schto173/FormulaLAM/Electrical/ESC-BLDC-FORMULA1-V2_0/bldc-75v.kicad_pcb

## KiCad design Electrical/ESC-BLDC-FORMULA1-V2_0/bldc-75v.kicad_pcb (2026-10-26)

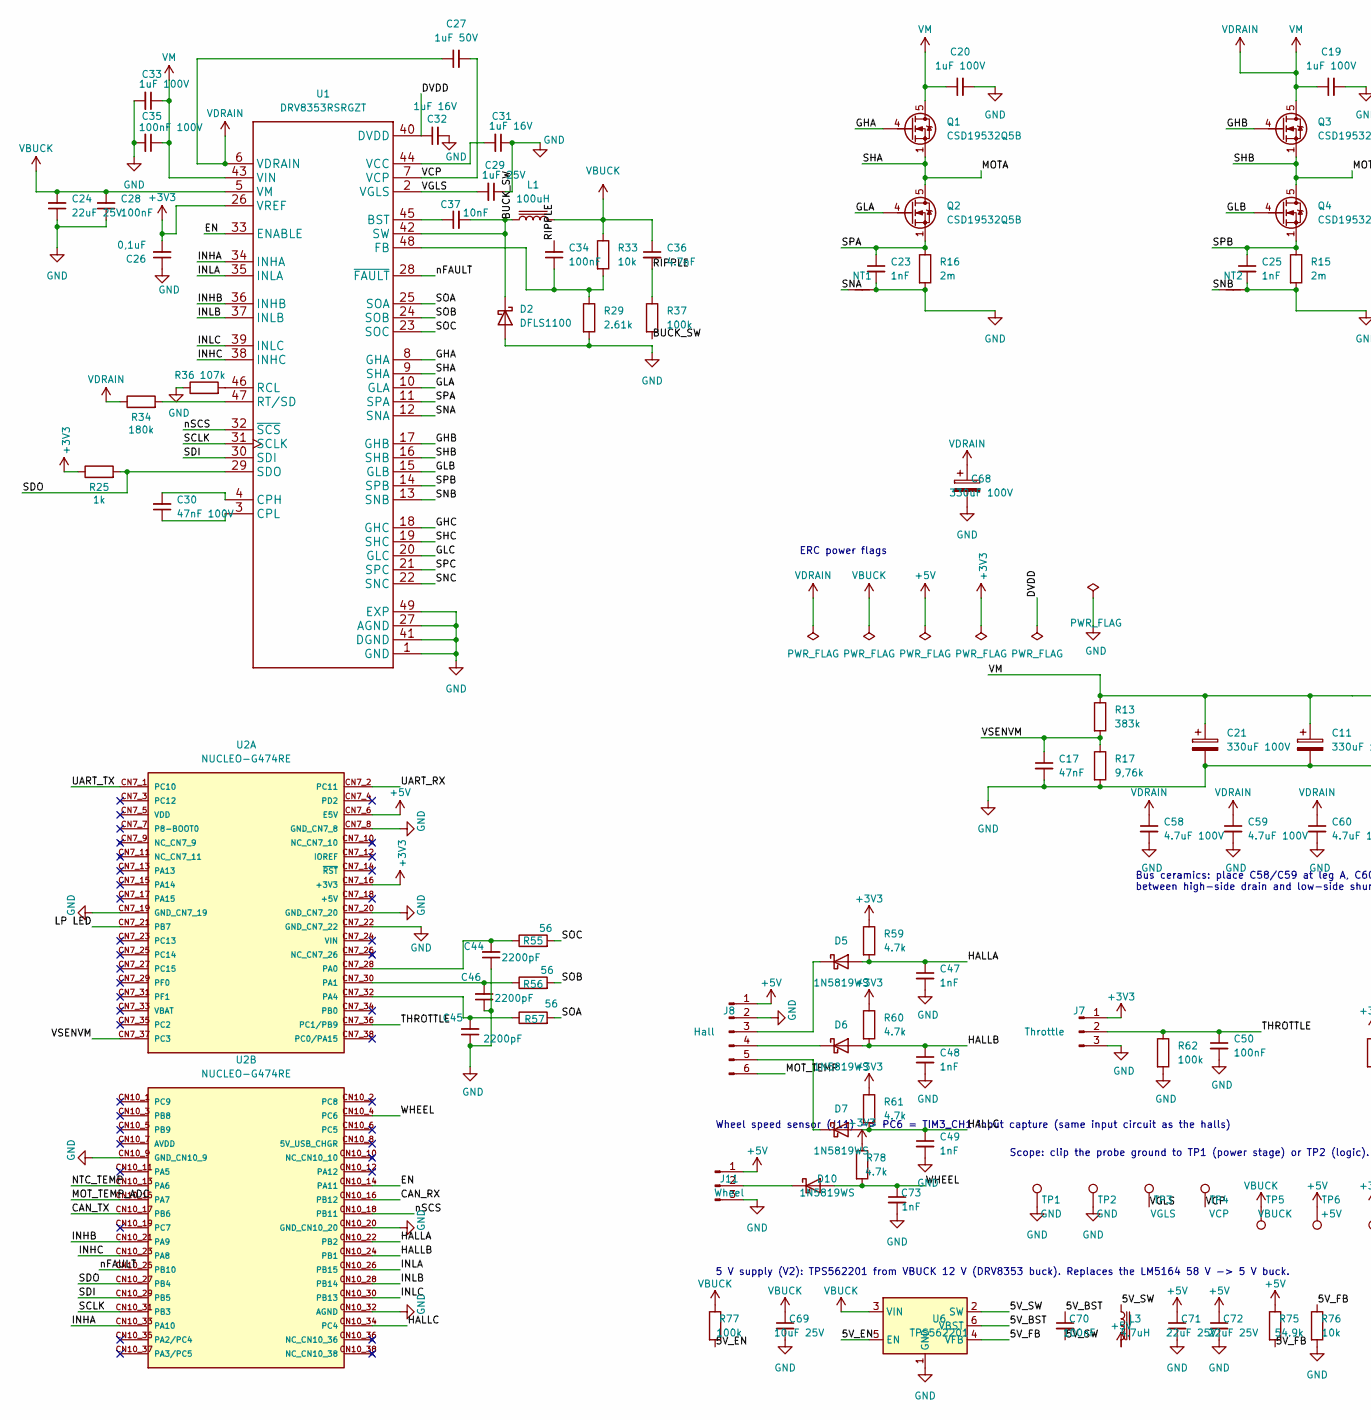
[picture p1: schematic bldc-75v.kicad_sch, part in row 1, column 1]

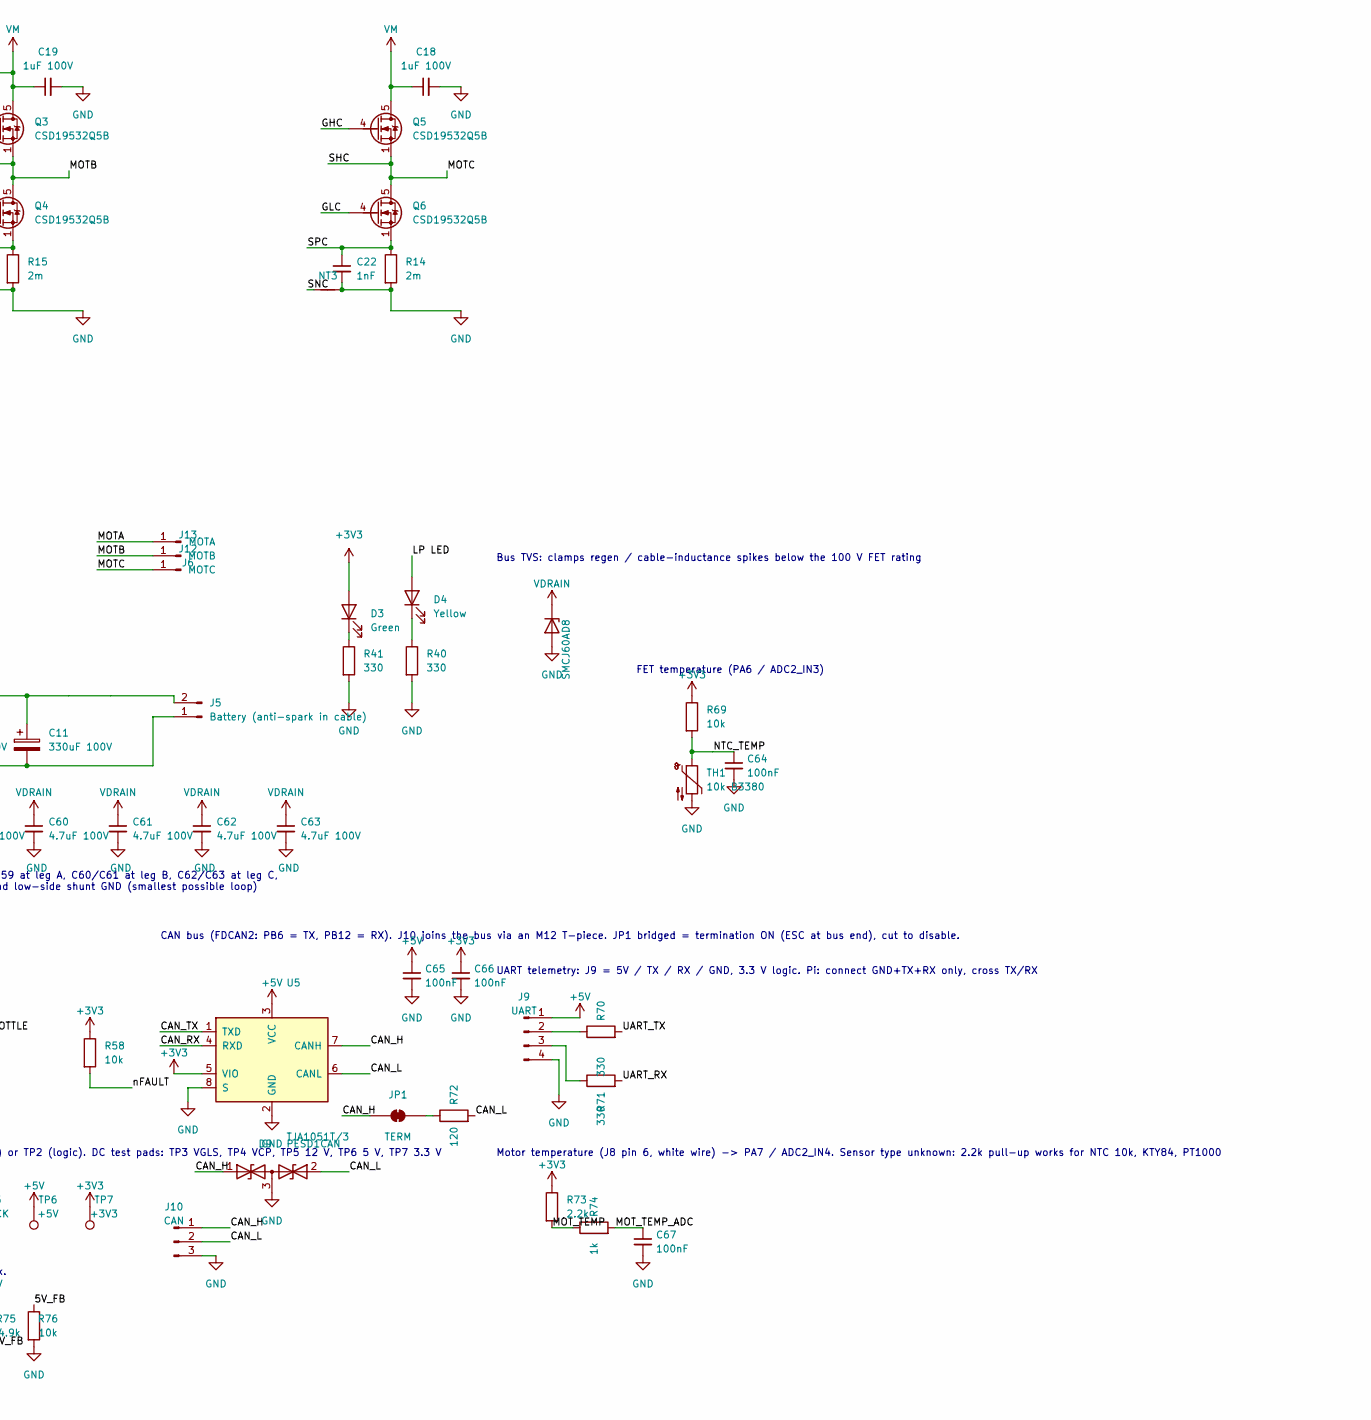
[picture p2: schematic bldc-75v.kicad_sch, part in row 1, column 2]

Parts:
C11, C21, C68: 330uF 100V; CP_Radial_D16.0mm_P7.50mm; LCSC C346987
C17: 47nF; C_0603_1608Metric; LCSC C1622
C18, C19, C20, C33: 1uF 100V; C_1206_3216Metric; LCSC C13832
C22, C23, C25, C47, C48, C49, C73: 1nF; C_0603_1608Metric; LCSC C1588
C24: 22uF 25V; C_0805_2012Metric; LCSC C45783
C26: 0,1uF; C_0603_1608Metric; LCSC C14663
C27: 1uF 50V; C_0603_1608Metric; LCSC C15849
C28, C34, C50, C64, C65, C66, C67, C70: 100nF; C_0603_1608Metric; LCSC C14663
C29: 1uF 25V; C_0603_1608Metric; LCSC C15849
C30: 47nF 100V; C_0603_1608Metric; LCSC C576852
C31, C32: 1uF 16V; C_0603_1608Metric; LCSC C15849
C35: 100nF 100V; C_0805_2012Metric; LCSC C28233
C36: 4.7nF; C_0603_1608Metric; LCSC C53987
C37: 10nF; C_0603_1608Metric; LCSC C57112
C44, C45, C46: 2200pF; C_0603_1608Metric; LCSC C1604
C58, C59, C60, C61, C62, C63: 4.7uF 100V; C_1210_3225Metric; LCSC C385986
C69: 10uF 25V; C_0805_2012Metric; LCSC C15850
C71, C72: 22uF 25V; C_1206_3216Metric; LCSC C12891
D2: DFLS1100; D_PowerDI-123; LCSC C107674
D3: Green; LED_0603_1608Metric; LCSC C12624
D4: Yellow; LED_0603_1608Metric; LCSC C2287
D5, D6, D7, D10: 1N5819WS; D_SOD-323; LCSC C191023
D8: SMCJ60A; D_SMC; LCSC C224057
D9: PESD1CAN; SOT-23; LCSC C15771
J5: Battery (anti-spark in cable); SolderWire-2.5sqmm_1x02_P8.8mm_D2.4mm_OD4.4mm
J6: MOTC; SolderWire-2.5sqmm_1x01_D2.4mm_OD4.4mm
J7: Throttle; JST_XH_B3B-XH-A_1x03_P2.50mm_Vertical; LCSC C144394
J8: Hall; JST_XH_B6B-XH-A_1x06_P2.50mm_Vertical; LCSC C144397
J9: UART; JST_XH_B4B-XH-A_1x04_P2.50mm_Vertical; LCSC C144395
J10: CAN; JST_XH_B3B-XH-A_1x03_P2.50mm_Vertical; LCSC C144394
J11: Wheel; JST_XH_B3B-XH-A_1x03_P2.50mm_Vertical; LCSC C144394
J12: MOTB; SolderWire-2.5sqmm_1x01_D2.4mm_OD4.4mm
J13: MOTA; SolderWire-2.5sqmm_1x01_D2.4mm_OD4.4mm
JP1: TERM; SolderJumper-2_P1.3mm_Bridged_RoundedPad1.0x1.5mm
L1: 100uH; L_Sunlord_SWPA6045S; LCSC C60633
L3: 4.7uH; L_Sunlord_SWPA4030S; LCSC C57269
NT1, NT2, NT3: NetTie_2; NetTie-2_SMD_Pad0.5mm
Q1, Q2, Q3, Q4, Q5, Q6: CSD19532Q5B; TDSON-8-1; LCSC C473333
R13: 383k; R_1206_3216Metric; LCSC C247277
R14, R15, R16: 2m; R_2512_6332Metric; LCSC C154685
R17: 9,76k; R_0603_1608Metric; LCSC C23128
R25, R74: 1k; R_0603_1608Metric; LCSC C21190
R29: 2.61k; R_0603_1608Metric; LCSC C22942
R33, R58, R69, R76: 10k; R_0603_1608Metric; LCSC C25804
R34: 180k; R_1206_3216Metric; LCSC C17923
R36: 107k; R_0603_1608Metric; LCSC C14889
R37: 100k; R_1206_3216Metric; LCSC C17900
R40, R41, R70, R71: 330; R_0603_1608Metric; LCSC C23138
R55, R56, R57: 56; R_0603_1608Metric; LCSC C25196
R59, R60, R61, R78: 4.7k; R_0603_1608Metric; LCSC C23162
R62, R77: 100k; R_0603_1608Metric; LCSC C25803
R72: 120; R_0603_1608Metric; LCSC C22787
R73: 2.2k; R_0603_1608Metric; LCSC C4190
R75: 54.9k; R_0603_1608Metric; LCSC C23077
TH1: 10k B3380; R_0402_1005Metric; LCSC C77131
TP1, TP2: GND; TestPoint_Keystone_5000-5004_Miniature; LCSC C238122
TP3: VGLS; TestPoint_Pad_D1.5mm
TP4: VCP; TestPoint_Pad_D1.5mm
TP5: VBUCK; TestPoint_Pad_D1.5mm
TP6: +5V; TestPoint_Pad_D1.5mm
TP7: +3V3; TestPoint_Pad_D1.5mm
U1: DRV8353RSRGZT; QFN50P700X700X100-49N; PARTREV A; LCSC C506246
U2: NUCLEO-G474RE; Nucleo64_Morpho_HAT; PARTREV 17
U5: TJA1051T/3; SOIC-8_3.9x4.9mm_P1.27mm; LCSC C38695
U6: TPS562201; TSOT-23-6; LCSC C90061

Connections:
+3V3: C26.2, C66.1, D3.2 (A), J7.1, R25.1, R58.1, R59.1, R60.1, R61.1, R69.1, R73.1, R78.1, TP7.1, U1.26 (VREF), U2.CN7_16 (+3V3), U5.5 (VIO)
+5V: C65.1, C71.1, C72.1, J8.1, J9.1, J11.1, L3.2, R75.1, TP6.1, U2.CN7_6 (E5V), U5.3 (VCC)
/5V_BST: C70.1, U6.6 (VBST)
/5V_EN: R77.2, U6.5 (EN)
/5V_FB: R75.2, R76.1, U6.4 (VFB)
/5V_SW: C70.2, L3.1, U6.2 (SW)
/BUCK_SW: C37.2, D2.1 (K), L1.1, R37.2, U1.42 (SW)
/CAN_H: D9.1 (A1), J10.1, JP1.1 (A), U5.7 (CANH)
/CAN_L: D9.2 (A2), J10.2, R72.2, U5.6 (CANL)
/CAN_RX: U2.CN10_16 (PB12), U5.4 (RXD)
/CAN_TX: U2.CN10_17 (PB6), U5.1 (TXD)
/DVDD: C32.1, U1.40 (DVDD)
/EN: U1.33 (ENABLE), U2.CN10_14 (PA11)
/GHA: Q1.4 (G), U1.8 (GHA)
/GHB: Q3.4 (G), U1.17 (GHB)
/GHC: Q5.4 (G), U1.18 (GHC)
/GLA: Q2.4 (G), U1.10 (GLA)
/GLB: Q4.4 (G), U1.15 (GLB)
/GLC: Q6.4 (G), U1.20 (GLC)
/HALLA: C47.1, D5.2 (A), R59.2, U2.CN10_22 (PB2)
/HALLB: C48.1, D6.2 (A), R60.2, U2.CN10_24 (PB1)
/HALLC: C49.1, D7.2 (A), R61.2, U2.CN10_34 (PC4)
/INHA: U1.34 (INHA), U2.CN10_33 (PA10)
/INHB: U1.36 (INHB), U2.CN10_21 (PA9)
/INHC: U1.38 (INHC), U2.CN10_23 (PA8)
/INLA: U1.35 (INLA), U2.CN10_26 (PB15)
/INLB: U1.37 (INLB), U2.CN10_28 (PB14)
/INLC: U1.39 (INLC), U2.CN10_30 (PB13)
/LP LED: D4.2 (A), U2.CN7_21 (PB7)
/MOTA: J13.1, Q1.1 (S), Q1.2 (S), Q1.3 (S), Q2.5 (D), U1.9 (SHA)
/MOTB: J12.1, Q3.1 (S), Q3.2 (S), Q3.3 (S), Q4.5 (D), U1.16 (SHB)
/MOTC: J6.1, Q5.1 (S), Q5.2 (S), Q5.3 (S), Q6.5 (D), U1.19 (SHC)
/MOT_TEMP: J8.6, R73.2, R74.1
/MOT_TEMP_ADC: C67.1, R74.2, U2.CN10_15 (PA7)
/NTC_TEMP: C64.1, R69.2, TH1.1, U2.CN10_13 (PA6)
/RIPPLE: C34.2, C36.2, R37.1
/SCLK: U1.31 (SCLK), U2.CN10_31 (PB3)
/SDI: U1.30 (SDI), U2.CN10_29 (PB5)
/SDO: R25.2, U1.29 (SDO), U2.CN10_27 (PB4)
/SNA: NT1.1, U1.12 (SNA)
/SNB: NT2.1, U1.13 (SNB)
/SNC: NT3.1, U1.22 (SNC)
/SOA: R57.2, U1.25 (SOA)
/SOB: R56.2, U1.24 (SOB)
/SOC: R55.2, U1.23 (SOC)
/SPA: C23.1, Q2.1 (S), Q2.2 (S), Q2.3 (S), R16.1, U1.11 (SPA)
/SPB: C25.1, Q4.1 (S), Q4.2 (S), Q4.3 (S), R15.1, U1.14 (SPB)
/SPC: C22.1, Q6.1 (S), Q6.2 (S), Q6.3 (S), R14.1, U1.21 (SPC)
/THROTTLE: C50.1, J7.2, R62.1, U2.CN7_36 (PC1/PB9)
/UART_RX: R71.2, U2.CN7_2 (PC11)
/UART_TX: R70.2, U2.CN7_1 (PC10)
/VCP: C27.2, TP4.1, U1.7 (VCP)
/VGLS: C29.2, TP3.1, U1.2 (VGLS)
/VSENVM: C17.1, R13.2, R17.1, U2.CN7_37 (PC3)
/WHEEL: C73.1, D10.2 (A), R78.2, U2.CN10_4 (PC6)
/nFAULT: R58.2, U1.28 (~FAULT), U2.CN10_25 (PB10)
/nSCS: U1.32 (~SCS), U2.CN10_18 (PB11)
GND: C11.2, C17.2, C18.2, C19.2, C20.2, C21.2, C22.2, C23.2, C24.1, C25.2, C26.1, C28.1, C29.1, C31.1, C32.2, C33.2, C35.2, C44.1, C45.1, C46.1, C47.2, C48.2, C49.2, C50.2, C58.2, C59.2, C60.2, C61.2, C62.2, C63.2, C64.2, C65.2, C66.2, C67.2, C68.2, C69.2, C71.2, C72.2, C73.2, D2.2 (A), D8.2 (A), D9.3 (common), J5.1, J7.3, J8.2, J9.4, J10.3, J11.3, NT1.2, NT2.2, NT3.2, R14.2, R15.2, R16.2, R17.2, R29.2, R36.1, R40.2, R41.2, R62.2, R76.2, TH1.2, TP1.1, TP2.1, U1.1 (GND), U1.27 (AGND), U1.41 (DGND), U1.49 (EXP), U2.CN7_8 (GND_CN7_8), U2.CN7_19 (GND_CN7_19), U2.CN7_20 (GND_CN7_20), U2.CN7_22 (GND_CN7_22), U2.CN10_9 (GND_CN10_9), U2.CN10_20 (GND_CN10_20), U2.CN10_32 (AGND), U5.2 (GND), U5.8 (S), U6.1 (GND)
unnamed: D3.1 (K), R41.1
unnamed: D4.1 (K), R40.1
unnamed: D5.1 (K), J8.3
unnamed: D6.1 (K), J8.4
unnamed: D7.1 (K), J8.5
unnamed: D10.1 (K), J11.2
unnamed: J9.2, R70.1
unnamed: J9.3, R71.1
unnamed: JP1.2 (B), R72.1
unnamed: C37.1, U1.45 (BST)
unnamed: C30.2, U1.4 (CPH)
unnamed: C30.1, U1.3 (CPL)
unnamed: C34.1, R29.1, R33.2, U1.48 (FB)
unnamed: R36.2, U1.46 (RCL)
unnamed: R34.2, U1.47 (RT/SD)
unnamed: C31.2, U1.44 (VCC)
unnamed: C44.2, R55.1, U2.CN7_28 (PA0)
unnamed: C46.2, R56.1, U2.CN7_30 (PA1)
unnamed: C45.2, R57.1, U2.CN7_32 (PA4)
VBUCK: C24.2, C28.2, C36.1, C69.1, L1.2, R33.1, R77.1, TP5.1, U1.5 (VM), U6.3 (VIN)
VDRAIN: C11.1, C18.1, C19.1, C20.1, C21.1, C27.1, C33.1, C35.1, C58.1, C59.1, C60.1, C61.1, C62.1, C63.1, C68.1, D8.1 (K), J5.2, Q1.5 (D), Q3.5 (D), Q5.5 (D), R13.1, R34.1, U1.6 (VDRAIN), U1.43 (VIN)

Notes on the sheet:
Bus ceramics: place C58/C59 at leg A, C60/C61 at leg B, C62/C63 at leg C, between high-side drain and low-side shunt GND (smallest possible loop)
ERC power flags
Bus TVS: clamps regen / cable-inductance spikes below the 100 V FET rating
FET temperature (PA6 / ADC2_IN3)
UART telemetry: J9 = 5V / TX / RX / GND, 3.3 V logic. Pi: connect GND+TX+RX only, cross TX/RX
CAN bus (FDCAN2: PB6 = TX, PB12 = RX). J10 joins the bus via an M12 T-piece. JP1 bridged = termination ON (ESC at bus end), cut to disable.
Motor temperature (J8 pin 6, white wire) -> PA7 / ADC2_IN4. Sensor type unknown: 2.2k pull-up works for NTC 10k, KTY84, PT1000
5 V supply (V2): TPS562201 from VBUCK 12 V (DRV8353 buck). Replaces the LM5164 58 V -> 5 V buck.
Wheel speed sensor (J11) -> PC6 = TIM3_CH1 input capture (same input circuit as the halls)
Scope: clip the probe ground to TP1 (power stage) or TP2 (logic). DC test pads: TP3 VGLS, TP4 VCP, TP5 12 V, TP6 5 V, TP7 3.3 V

Board: 4 copper layers, 122 parts (0 on the bottom side), 79 nets, no tracks yet.

Other parts of the board:
H1, H2, H3, H4: M3; MountingHole_3.2mm_M3
