schto173/FormulaLAM/(commit log)

2026-06-25 added new scripts from raspberry pi
2026-09-28 Add ESC BLDC motor controller HAT (KiCad project + JLCPCB files)
    DRV8353RS + 6x CSD19532Q5B HAT for the NUCLEO-G474RE (SimpleFOC, 6-PWM,
    low-side current sense, halls). Includes bus TVS, FET temperature NTC,
    UART telemetry and CAN (TJA1051T/3), plus the current JLCPCB gerbers,
    BOM and pick-and-place files. README has the pin map and order settings.
    [bldc-75v-B_Cu.gbl, bldc-75v-B_Mask.gbs, bldc-75v-B_Paste.gbp, bldc-75v-B_Silkscreen.gbo, bldc-75v-Edge_Cuts.gm1, bldc-75v-F_Cu.gtl, bldc-75v-F_Mask.gts, bldc-75v-F_Paste.gtp]
2026-09-28 ESC: add SimpleFOC bring-up firmware, fix VCP UART name in README
    PlatformIO project (NUCLEO-G474RE) with five bring-up steps selected by
    environment: DRV8353 SPI check, hall test, open loop, closed loop (halls),
    FOC with low-side current sensing. Configures the DRV8353 over SPI
    (IDRIVE 150/300 mA, VDS_LVL 0.4 V, CSA gain 20 V/V). Not yet compiled.
    The Nucleo's ST-LINK virtual COM port is LPUART1, not USART2.
    [board.h, drv8353.h, main.cpp]
2026-09-28 ESC firmware: pin toolchain versions so it builds, move build dir
    - ststm32@19.7.1 (STM32 Arduino core 2.12): SimpleFOC 2.4.0 does not
    compile against core 3.0 (enableTimerClock signature changed)
    - Simple FOC pinned to 2.4.0
    - workspace_dir under the PlatformIO core dir: the project path plus
    SimpleFOC's nested includes exceeded the 260-char Windows path limit
    All five bring-up environments build (flash <= 17 %, RAM 3.3 %).
2026-09-28 ESC firmware: friendlier serial monitor for the SimpleFOC Commander
    Local echo, LF line ending and send-on-Enter, so commands like "T2" can
    be typed and edited before they are sent.
2026-10-14 ESC: final ordered V1.2, handoff notes for Claude Code, JLC tools
    - Board/schematic/JLC files exactly as ordered at JLCPCB (generated
    2026-09-30): motor temperature input on J8 pin 6 -> PA7, GND via for the
    C67 island, C31 via moved, R73 label, J8/J9/J10 1.0 mm holes
    - CLAUDE.md: status, hardware facts, motor data, car-level decisions,
    firmware decisions and to-do list, release checklist, gotchas
    - tools/: gen_jlc.py + lcsc_map.py (reproduce the ordered BOM/CPL byte for
    byte), overlay.py (JLC footprint rotation check), dfm_checks.py
    - README: 6-pin J8, PA7 motor temperature, order status, tools
    - firmware/README: bring up at 20-24 V (LM5164 EN/UVLO turns on at 18 V)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
2026-10-14 ESC firmware: FET + motor temperature reading with derating
    - include/analog_in.h: temperatures, throttle and bus voltage read with
    register-level single conversions on ADC2's free regular group, so they
    run alongside SimpleFOC's injected current sensing. analogRead() must not
    be used once current sensing runs: the STM32 core force-resets ADC1+ADC2
    after every analogRead().
    - Step 1 prints the motor sensor resistance and a type guess (NTC 10k /
    KTY84 / PT1000); set MOTOR_TEMP_SENSOR in board.h afterwards.
    - Steps 3-5: temperature check every 200 ms, linear derating above
    FET 80 C / motor 90 C, stop at 100 C / 110 C, status line every second.
    - All five environments compile; not y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
2026-10-14 ESC firmware: fix SOA/SOC pin swap, safe bring-up voltages, step 0 power check
    - Current sense pins were crossed: on the board SOA -> R57 -> PA4 and SOC -> R55 -> PA0
    (checked in the netlist). board.h, README pin map and CLAUDE.md now match the hardware.
    - VOLTAGE_LIMIT 3.0 -> 0.5 V, ALIGN_VOLTAGE 1.5 -> 0.4 V: the 7070 has ~0.054 Ohm, so at
    standstill 3 V would push ~50 A and collapse a current-limited bench supply below the
    16.8 V UVLO of the 5 V regulator. 0.5 V is ~8-10 A.
    - firmware/README: new step 0 (rails without the Nucleo: 5.0 V on J9.1, 12.1 V across C24).
    - CLAUDE.md: boards received, PlatformIO install workaround, building all environments.
    All five environments build.
    C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
2026-10-14 ESC firmware: read bus voltage via ADC2 at start-up; step 0 + 1 pass on board #1
    First power-up of board #1: 5 V = 4.977 V, VBUCK = 12.072 V, DRV8353 registers all ok,
    no faults. But analogRead(PC3) returned 0.0 V while ain::busVolts() read 23.3 V, so steps
    3-5 would have stopped with "bus voltage below 9 V".
    - Every step now starts with ain::begin(false) + ain::busVolts(); readBusVoltage() removed,
    no analogRead() left in the firmware.
    - Step 5: new ain::end() switches ADC2 off before current_sense.init(), so SimpleFOC sets it
    up from scratch; ain::begin(true) afterwards as before.
    - CLAUDE.md: bring-up results so far.
2026-10-14 ESC bring-up: halls ok, 7 pole pairs confirmed, motor sensor is an NTC 10k
    - Hall test counts signed steps along the sequence 1-3-2-6-4-5 (wiggling by hand cancels
    out) and reports skipped steps / invalid states as errors. Result on the 7070: 42 net
    steps per turn = 7 pole pairs, no errors.
    - Motor temperature sensor reads 11.85 kOhm at ~21 C -> MOTOR_TEMP_SENSOR = NTC10K.
2026-10-14 ESC firmware: fix jerking open loop (driver.voltage_limit), quiet status line, L command
    First spin on the real board only jerked back and forth. Cause: driver.voltage_limit was set
    to the motor limit (0.5 V); SimpleFOC centres the phases at driver.voltage_limit/2, so the
    duty was 0-2 % and the <1 us high-side pulses were mostly eaten by the dead time.
    - driver.voltage_limit = Vbus (phases centred at Vbus/2); motor.voltage_limit stays 0.5 V.
    - MCU dead time 500 -> 100 ns (DRV8353 adds 100 ns + VGS handshake, no shoot-through).
    - SimpleFOC monitor off by default (it printed hundreds of lines/s and blocked typing);
    instead one "# target | speed | Uq | limit | (Iq) | FET | motor | Vbus | pow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
2026-10-14 ESC bring-up: step 3 (open loop) passes on board #1
2026-10-14 ESC bring-up: step 4 passes; step 5 gets safe current-PI start values
    - Step 4 (halls, voltage mode) on board #1: sensor dir CCW, PP check ok, zero angle 3.14,
    T1.0 -> 16 rad/s with no load.
    - Step 5: current PI starts at P 0.05 / I 50 instead of SimpleFOC's gimbal-motor defaults
    (P 3 / I 300 would oscillate on a 0.05 Ohm motor); own FOC_VOLTAGE_LIMIT (1 V) so the
    motor can spin in current mode. README: measure R/L with MFP0.4, tune with MFC200.
2026-10-14 ESC firmware: hall smoothing, measured current PI, 512-byte serial buffer
    Step 5 first run on board #1: current sense alignment "Success: 1" (A/C pin fix and gain
    sign confirmed), MFP0.4 -> R 0.16 Ohm (incl. FETs/wires), Ld 50 uH, Lq 70 uH; MFC200 ->
    Pq 0.09, Pd 0.06, I 199. Motor ran but went "grgrgr" with a "clack" about once a second.
    - SERIAL_TX_BUFFER_SIZE=512: the ~110-char status line overflowed the 64-byte buffer and
    blocked loopFOC for several ms once per second (likely the clack).
    - SimpleFOCDrivers 1.0.9 SmoothingSensor between HallSensor and motor (HALL_SMOOTHING in
    board.h): interpolates between the 60-degree hall steps, -30 deg phase correction.
    - Current PI defaults = the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
2026-10-14 ESC firmware: current LPF matches the MFC200 tuning (cutoff 1 kHz)
2026-10-14 ESC bring-up: step 5 (FOC current control) passes - all bring-up steps done on board #1
2026-10-14 ESC firmware: throttle control (step 5), no regen, bus over-voltage stop, PWM follows Vbus
    - Throttle on J7 sets the current (0..L amps), must be released once to arm, 10 A/s ramp up,
    immediate drop, invalid signal -> 0 A; live calibration AI / AF, A0 / A1 on/off.
    - No regenerative braking: a target against the rotation above 3 rad/s becomes 0, MLU cannot be
    lowered while spinning (a bench supply cannot take energy back, the 660 uF bus would overshoot).
    - Bus checked every 1 ms, driver off above BUS_OV_LIMIT (40 V on the bench).
    - driver.voltage_power_supply / voltage_limit follow the measured bus every 200 ms.
    - Step 1 prints the throttle in volts.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
2026-10-14 ESC firmware: throttle dead band on calibration, defaults for the hall throttle (0.87 / 2.60 V)
2026-10-14 ESC bring-up: 2530 rpm at 30 V with throttle, motor constant measured (KV ~120)
2026-10-14 ESC firmware: SpaceVectorPWM, MLU capped at 0.55 x Vbus
    SVPWM (midpoint clamp) gives Vbus/sqrt(3) instead of Vbus/2 per phase (+15.5 %). 5000 rpm needs
    ~26 V per phase: SinePWM only above ~52 V bus, SVPWM above ~45 V (most of a 14S pack).
    MLU above 0.55 x Vbus is refused (phases would clip and the low-side shunts lose their sampling time).
2026-10-14 ESC bring-up: 3450 rpm at 30 V with SVPWM, full-speed run, note on current sensing at high modulation
2026-10-14 ESC firmware: 12S battery build (env 5_foc_battery)
    - BATTERY_CELLS (default 0 = bench): 12S -> over-voltage stop 55.4 V, refuse to start outside
    36.0..51.0 V, current derated linearly 38.4 V -> 36.0 V (3.2 -> 3.0 V/cell, coast, no stop).
    - Bench build refuses to start above 35 V (so it can't run on the pack by mistake).
    - README: battery section, first-connection checklist.
2026-10-14 ESC notes: battery is 12S, speed range per charge state
2026-10-14 ESC: V2 draft plan (Nucleo HAT, option A supply, FOC/safety ideas, scope GND points)
    V2-PLAN.md collects the ideas for the next board: true Nucleo-HAT size,
    DRV buck 12 V for VM + small 12->5 V buck (drops the LM5164), magnetic
    encoder, inline current sensing, battery energy meter, wheel speed input,
    reverse-polarity protection, hardware e-stop + watchdog, locking
    connectors, scope ground loops / probe-spring GND pads, V1 DFM lessons.
    CLAUDE.md only gets a pointer to it.
2026-10-15 ESC firmware: battery build start limit 51.6 V (4.30 V/cell), alignment 0.6 V on the battery
    At 50 V the dead time costs ~0.2 V, so the 0.4 V bench alignment voltage would leave only ~0.2 V.
    51.0 V start limit was too tight for a freshly charged 50.4 V pack plus measurement tolerance.
2026-10-15 ESC firmware: quiet standstill - DRV8353 COAST when the throttle is released and the motor stopped
    On the 12S pack the motor hissed at standstill: holding 0 A with the FETs switching. Now the DRV_CTRL
    COAST bit turns all six FETs off when the throttle is released and |speed| < 1 rad/s (back on when
    pressed, or above 5 rad/s). PWM and the current loop keep running underneath. Coasting at speed is a
    TODO: re-engaging then needs the back-EMF voltage preloaded, else a short-circuit current spike.
2026-10-15 ESC bring-up: first run on the 12S pack, 5250 rpm no-load at 43.6 V
2026-10-15 ESC firmware: automatic voltage cap in step 5 (0.55 x Vbus, follows the battery)
    MLU<volts> = lower manual cap for tests, MLU0 = automatic. Applied with updateVoltageLimit() so the
    current PI limits follow. Status line shows 'Umax <V> auto/man'.
2026-10-15 ESC firmware: read DRV8353 faults BEFORE pulling EN low, print the state at the stop
    First nFAULT stop on the 12S pack (~510 rad/s, Iq 2.6 A, 43.6 V) printed FAULT2 = 0x7FF (every bit):
    halt() pulled EN low first, the sleeping DRV doesn't answer on SPI and the SDO pull-up reads as all 1s.
    Now: snapshot (speed, Uq, Iq, Vbus, nFAULT) -> PWM off -> read faults -> EN low.
2026-10-15 ESC: board #1 lost its low-side gate supply (GDUV, VGLS 3 V) - notes, voltage cap 0.45 x Vbus for now
2026-10-15 ESC firmware: safe fixed settings - no automatic voltage cap, sine PWM, raw halls, hard stops
    After board #1's DRV8353 failed near full modulation (auto cap 0.55 x Vbus):
    - Fixed motor voltage cap FOC_VOLTAGE_MAX: 14 V battery build (~3000 rpm), 9 V bench build.
    Start refused if it is above 0.40 x Vbus. MLU can only lower it. No automatic adjustment.
    - Plain sine PWM (USE_SVPWM 0), hall angle without smoothing (HALL_SMOOTHING 0).
    - Temperatures: hard stop at FET 90 C / motor 100 C, no derating.
    - Battery: hard stop below 36.0 V (3.0 V/cell) for more than 2 s, no derating.
    Kept: over-voltage stop, DRV fault stop, throttle arming + 10 A/s ramp, no braking against the
    rotation, PWM scaled wit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
2026-10-15 ESC firmware: drive mode - throttle = max speed, 10 A hard, +2 A/s, plus DRV protections
    Efficiency car: throttle 0-100 % = maximum speed 0-40 km/h. P speed controller (2 A per km/h too slow)
    -> motor current 0..10 A (hard), rising at most 2 A/s (soft freewheel engagement), dropping at once,
    never negative (freewheel hub, no braking). Released = 0 A, coast; COAST once the motor stands still.
    Gear 8:1 / wheel 0.508 m assumed (GEAR_RATIO / WHEEL_DIAMETER_M, to confirm).
    Voltage cap 17 V but never above 0.40 x Vbus; the target speed is limited to what the cap can deliver.
    Protections after board #1's DRV failure:
    - CappedMotor: total |Uq,Ud| limited to the cap (SimpleFOC limits each separately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
2026-10-15 ESC V2.0: new project - placement only (not routed)
    - Copy of V1.2 with option-A supply (DRV buck 12 V for VM, TPS562201 12->5 V), phase
    voltage sensing and fuse removed, SMD bus caps + SMCJ54A, wheel speed input (PC6),
    scope GND loops + test pads (VGLS, VCP, 12 V, 5 V, 3.3 V), motor pads split J6/J12/J13
    - Board 98 x 90 mm on top of the Nucleo, ST-LINK end uncovered; power stage as a
    pinwheel around the 45 deg DRV8353 (gate paths 14-26 mm vs 30-45 mm on V1);
    connectors in strips above CN10 / below CN7 next to their pins; M3 holes in corners
    - Placement scripts in tools/; lcsc_map.py still V1 (see README)
2026-10-19 ESC V2.0: 60 V safe TVS (SMCJ60A), keep DRV8353 low-side current sensing
    - D8 SMCJ54A -> SMCJ60A (C224057): the 54 V part starts conducting at 60 V and would
    overheat on a 60 V battery; SMCJ60A breaks down at 66.7 V min, clamps at 96.8 V
    - Current sensing stays low-side with the DRV8353 amplifiers (inline INA240 variant
    kept as tools/optional/v2_sch_inline.py, not applied)
    - All parts on the battery line checked for 60 V: FETs 100 V, VDRAIN 100 V,
    DRV buck VIN 95 V, VM from the 12 V buck, caps 100 V
2026-10-19 ESC: state the board #1 failure mode clearly, drop the cracked-C29 theory
    Board #1: the DRV8353's internal low-side gate-drive supply (VGLS) was damaged by
    electrical overstress while switching at ~45 V - not a component defect, C29 is not
    the cause. V1.2 layout factors: 30-45 mm gate/source-sense traces not routed as pairs,
    low-side shunts in the SPx path, current readings degrading at ~93 % modulation.
    TI's DRV8353RH-EVM uses the same parts with the DRV beside the FETs; V2 copies that.
2026-10-19 ESC: board #1 root cause not determined - correct the trace-length claim
    Measured TI's DRV8353RH-EVM (MD016 layer PDF): FET gates are ~27-31 mm (straight line)
    from the DRV gate pins; V1.2 routed GH 33-45 / GL 21-35 / SP 17-33 mm - the same range,
    so trace length alone does not explain the failure. Failure mode stays as measured
    (DRV8353 VGLS supply damaged, C29 not the cause); root cause open.
2026-10-19 ESC firmware: IDRIVE 50/100 mA per TI's IDRIVE rule
    IDRIVE = Qgd / edge time with 100-300 ns edges (TI E2E FAQ); CSD19532Q5B Qgd 8.7 nC
    -> 50 mA source / 100 mA sink (~175 / ~87 ns edges), the gentlest DRV8353 setting.
    TI engineers name too high IDRIVE (charge coupled through Cgd into GLx pumping VGLS)
    as a way to damage the DRV8353's VGLS supply - board #1's failure mode.
    Was 150/300 at the failure, then 100/200. Builds: 1_drv_check, 5_foc_battery.
2026-10-19 ESC firmware: DRV8353 in 3x PWM mode, as on TI's DRV8353RH-EVM
    - BLDCDriver6PWM -> BLDCDriver3PWM: INHx = PWM (TIM1 CH1-3), INLx = per-phase enable
    (SimpleFOC enable/disable), the DRV makes the low-side signal + its 100 ns dead time
    after the VGS handshake; MCU dead_zone removed
    - DRV_CTRL_BASE = 0x020 (PWM_MODE 01b); start-up setting, COAST and CLR_FLT writes keep it
    - Low-side current sense timing unchanged (same TIM1, same sample point)
    - All six envs build. Re-run bring-up from step 1 at low voltage before the battery.
2026-10-19 ESC firmware: hall smoothing back on
    HALL_SMOOTHING 1: SmoothingSensor estimates the angle between the 60-degree hall steps
    (smooth sine instead of a 6-step staircase, quieter at low speed). It was switched off
    after board #1 only as part of the "simple settings" pass, no specific reason; earlier
    tests showed smoother running and symmetric speed in both directions.
    Builds: 4_closed_loop, 5_foc_current, 5_foc_battery.
2026-10-20 ESC: gear ratio 8:1 confirmed
2026-10-20 ESC bring-up: board #2 step 1 ok in 3x PWM mode, VGLS 12.1 V reference
2026-10-20 ESC firmware: open-loop 1.0 V, alignment 0.8 V bench / 1.2 V pack for 3x PWM + IDRIVE 50/100
    Board #2: open loop only rocked at 0.5 V and ran perfectly at 1.0 V - slower edges + the DRV's VGS
    handshake in 3x mode cost ~0.3-0.4 V at 24 V. Alignment voltages raised accordingly.
2026-10-20 ESC firmware: speed target keeps clear of the voltage cap, no PI wind-up during COAST
    Board #2 step 5 on the bench: speed control works, but it whistled at ~200 rad/s where Uq reached
    the 10 V cap. In 3x PWM mode with IDRIVE 50/100 the effective Ke is 0.048 (was 0.045 in 6x), so the
    target limit (cap - 1 V) / 0.045 drove the current loop into saturation. Now (cap - 1.5 V) / 0.050.
    While coasting the current PI integrated a small offset up to ~10 V; it is now held at 0 during COAST
    and the PWM is set to 0 V before COAST is left.
2026-10-20 ESC bring-up: board #2 bench steps 1-5 done in 3x PWM mode, no whistle below the cap
2026-10-20 ESC firmware: no fake fault list when stopping before the DRV8353 is started
    The bench build refused the 44 V pack (correct) and printed 0x7FF 0x7FF - the DRV was still asleep.
2026-10-20 ESC bring-up: board #2 on the 12S pack - speed control ok, clean phase edges at 44 V (no load)
2026-10-20 ESC: PC dashboard (Web Serial, Edge/Chrome) + firmware data mode D1/D0
    - firmware: 'D1' prints one $D,... line every 100 ms with existing values (speed, target, Iq/Id,
    Uq/Ud, cap, current limit, FET/motor temperature, Vbus, flags), 'D0' off, off after reset.
    No change to the control; temperatures/Vbus are the values of the 200 ms measurement.
    - firmware/dashboard/esc-dashboard.html: single file, no install: tiles with colour limits (FET
    amber 50 C, red 60 C), live graphs, peaks, board messages, command box, Save CSV.
2026-10-20 ESC dashboard: control panel (STOP / enable, current limit, voltage cap, throttle); ME1 only at standstill
    - Dashboard sends the existing commands from buttons: STOP = A0 + ME0 (all FETs off, coast),
    Enable = ME1 + A1, current limit L2/5/8/10 or a value (max 10 A), voltage cap MLU (max 17 V),
    throttle on/off/status/calibration. Every sent command appears in the message window.
    - Firmware: ME1 is refused while the motor turns (SimpleFOC's enable() sets all low sides on for a
    moment, which would brake a spinning motor).
2026-10-20 ESC dashboard: one-screen layout, no scrolling
    Left column: value tiles, controls, peaks; right: 2x2 graphs filling the height + message window.
    Explanations moved into tooltips, STOPPED warning as an overlay. Checked at 731 x 646 px: fits.
2026-10-20 ESC dashboard v2: instruments, efficiency figures, crosshair, markers, load-test guard, demo
    - speedometer with target needle, current and voltage-headroom dials, FET/motor/battery/throttle bars
    - motor power / battery current / energy / distance / Wh/km (PC-side estimates)
    - synchronized crosshair over the 4 graphs, pause view, named markers (also in the CSV)
    - load-test guard: optional auto-STOP at a set FET/motor temperature; Esc = STOP
    - demo mode with a simple 100 kg / 8:1 car model; light/dark toggle; status chips
    - one screen from ~1280 x 720 (checked 1280x720 and 1366x768), stacked + scrolling below 1100 px
2026-10-21 ESC: drive direction - MOTOR_DIRECTION in board.h, R1/R0 command, dashboard switch
    The drive logic uses driveDir (+1/-1) for the current command and the measured speed; speed limit,
    current limit, ramp, no-regen and COAST work the same in both directions. R0/R1 only at standstill
    with the throttle released. Data line flag 8 = reversed, speeds forward-positive; the dashboard shows
    and switches it (Controls -> Direction).
2026-10-21 ESC: current hard max 15 A (L up to 15), start-up limit stays 10 A; dashboard 15 A button
2026-10-21 ESC firmware: MOTOR_DIRECTION -1 (reversed is the right way, confirmed on board #2)
2026-10-21 ESC: current hard max 20 A (start-up still 10 A), dashboard 20 A button; scope under load clean
    Board #2 at max load, ~15 km/h, ~44 V: falling and rising phase edges clean (30-40 ns, small damped
    undershoot). 20 A only via L / the dashboard; ~12-15 W in the FETs continuous -> bursts only.
2026-10-21 ESC firmware: stall guard - blocked motor gets 0 A after 3 s, throttle must be released
    Board #2 buzzed when the wheel was held with the brake: all power is heat, concentrated in one phase,
    and the rotor rattles on a hall edge. Now: >= 5 A asked for while slower than 3 rad/s for 3 s ->
    current 0, '# STALL', re-arm by releasing the throttle (then COAST at standstill). A start on the flat
    needs < 2 A, so it is not affected. Data flag 16 = stall; dashboard banner + chip.
2026-10-21 ESC firmware: stall guard threshold 8 A (was 5 A)
2026-10-21 ESC firmware: SVPWM on, voltage cap 0.45 x Vbus / 19.5 V -> ~40 km/h; notes on load run and bus caps
    SVPWM gives the low-side shunts a longer window for the same motor voltage (max duty 0.5 + 0.866 U/Vbus):
    SVPWM at 0.45 x Vbus = 89 % max duty / 5.5 us window, more than sine at 0.40 (90 % / 5.0 us). Board #1
    died at SVPWM 0.55 (97.6 %, 1.2 us). Dashboard V cap input up to 19.5 V.
2026-10-21 ESC dashboard: speedometer 0-45 km/h with the 40 km/h limit marked (40 now reachable with SVPWM)
2026-10-21 ESC notes: SVPWM 0.45 test on the pack - 37.5 km/h, Iq scatter unchanged, FET 28 C
2026-10-26 ESC firmware: two-phase current reconstruction (VESC style) + live voltage fraction V0.45..0.55
    - TwoPhaseLowside: the phase above 80 % duty (low-side window < 10 us) is calculated from the
    other two (ia+ib+ic = 0); on after initFOC, X1/X0 to compare, status line 'recon x %'.
    - V<fraction>: voltage cap fraction live, 0.30..0.55 (lowering only at standstill); default 0.45.
    At 0.55 the 2nd-highest phase still has >= 4.4 us to measure. Cap max 24 V, speed limit 40 km/h.
    - Dashboard: fraction select (0.45..0.55) + Recon on/off.
2026-10-26 ESC: measured vs calculated Iq side by side (same samples) in the data line and dashboard
2026-10-26 ESC firmware: gear ratio 15:1 (speed display, 40 km/h limit and speed controller follow); notes on top speed
2026-10-26 ESC firmware: gear ratio 13.8:1
2026-10-26 ESC firmware: black box (last 1024 control cycles printed at every stop, dashboard saves CSV); direction normal again
2026-10-26 ESC V2.0: big THT bus caps again (3x 330 uF 100 V)
    C11/C21/C68: 330 uF 100 V 16x25 mm THT (Samyoung NXA C346987, the V1.2 part, 1.65 A
    ripple each = ~5 A) instead of SMD 47 uF 10x10 (too little ripple rating). Placed in
    the free corners beside the phase cells, outside the Nucleo area; board 110.5 x 90 mm
    (x 143-253.5), right corner holes moved. Parity 0, no courtyard overlaps.
2026-10-29 ESC firmware: gear ratio 9.41:1 (22-tooth pinion)
2026-10-29 ESC firmware-softstart: launch current curve + clutch take-up (separate folder)
    New folder firmware-softstart/ = copy of firmware/ (gear 9.41:1) plus, in step 5:
    - Launch curve: current limit follows the motor speed, 20 A at 0 km/h -> 15 A at
    7 km/h -> 10 A from 15 km/h (linear), 5 A/s ramp below 7 km/h, 2 A/s above; "L" caps it
    - Clutch take-up: throttle pressed with the motor below 2 km/h -> 1 s creep at ~1 km/h
    with max 4 A (takes up the clutch slack gently), then the launch curve
    Own PlatformIO workspace (ws/esc-hat-softstart). firmware/ is unchanged.
    Builds: 5_foc_current, 5_foc_battery.
2026-10-29 ESC V2.0: FUTURE-IMPROVEMENTS.md
    Collected ideas: discontinuous PWM (bottom clamping), merging firmware-softstart,
    re-engage at wheel speed, understanding the 0.48 VDS_OCP trip, pulse-and-glide,
    16 kHz PWM, Wh/km logging; hybrid polymer bus caps, separate Pi/display supply,
    open V2-PLAN items, parked INA240 variant; gear ~8:1, smaller motor, mechanics.
2026-10-29 ESC V2.0: future improvements - correct the bus capacitor note
    Hybrid polymer caps only come small at 100 V (10-15 uF through-hole); the Samyoung NXA
    330 uF low-ESR electrolytics are already one of the best choices. More ripple capacity
    = more caps of the same kind (V2: three; V1.2: a third across the battery pads).
2026-10-29 ESC V2.0: future improvements - in-wheel (rim) motor as long-term option
    Coreless axial-flux rim motor: no gear/chain and iron losses, no cogging (~95-97 %);
    needs a mechanical build and high PWM (low inductance) -> inline current sensing.
2026-11-09 ESC firmware-softstart: 30 A launch (30/20/10 A curve, 30 A/s rise), CSA gain 10 (+-70 A range)
2026-11-09 ESC firmware-softstart: 15 A floor (launch 30/20/15 A) with a 30 s time limit above 10 A for the bus caps
2026-11-09 ESC firmware-softstart: time limit as an account (launch exempt), allow forward push against slow backward spring-back
2026-11-09 ESC firmware: merge softstart into firmware/
    Clutch take-up, 30 A launch curve, CSA gain 10, 30 s bus-cap time account
    above 10 A and NO_REGEN_PUSH_SPEED ran well in the car, so they are now the
    main firmware. firmware-softstart/ removed (old firmware = 13a7ff9).
    CLAUDE.md: register values brought up to date (3x PWM, IDRIVE 50/100,
    latched OCP 0.3 V, CSA 0x240).
